Ashington258/Boost_Control/image/MCU.png

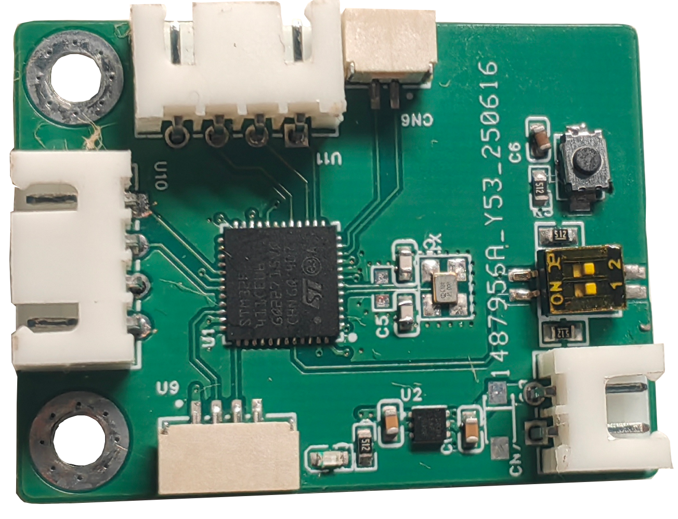
image/MCU.png
