Ashington258/Boost_Control/test/占空比裕度测试.md

# 占空比裕度测试
额定负载 100Omega情况下测试

| 输入电压 | 输出电压 | 占空比 | ADC电压 |
| --- | --- | --- | --- |
| 18V | 61.94V | 25% | 5.437V  |
| 18V | 53.436V  | 30% | 4.741V  |
| 18V | 40.108V  | 40% | 3.677V  |
| 18V | 32.822V  | 50% | 2.991V  |
| 18V | 27.720V  | 60% | 2.524V  |
| 18V | 23.959V  | 70% | 2.175V  |
