Ashington258/Boost_Control/image/Figure_1.png

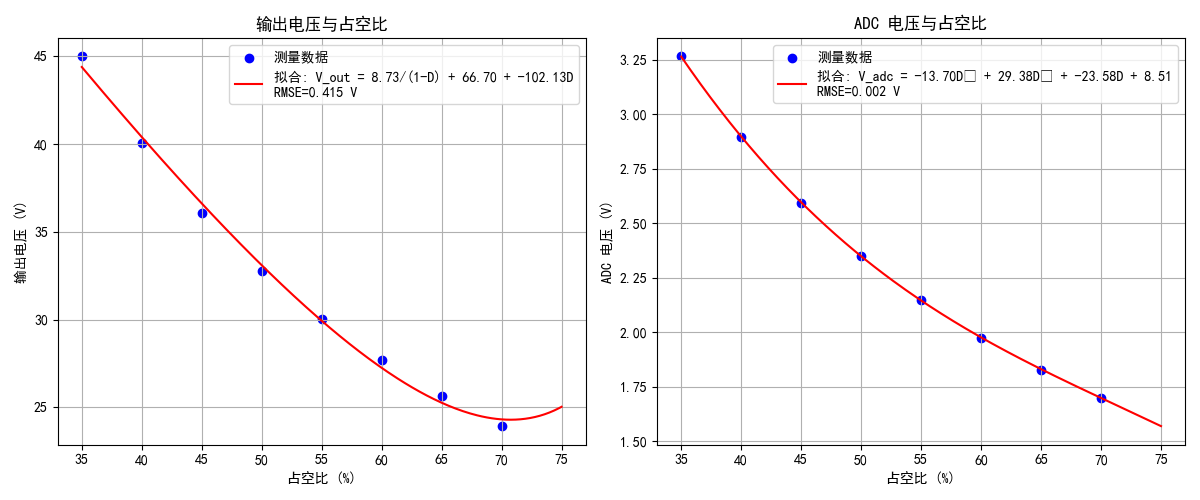
image/Figure_1.png
