Ashington258/Boost_Control/image/Figure_2.png

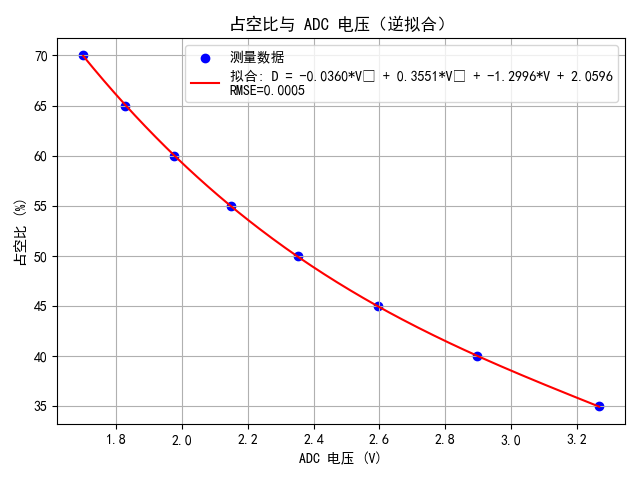
image/Figure_2.png
