Ashington258/Boost_Control/image/PWM_VADC.png

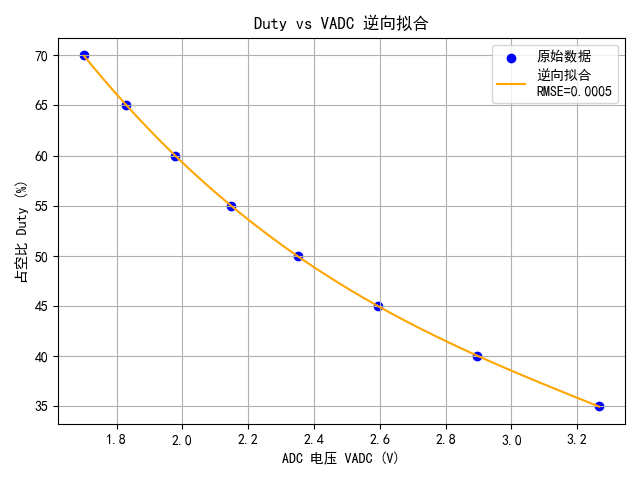
image/PWM_VADC.png
