Ashington258/Boost_Control/image/U0_VADC.png

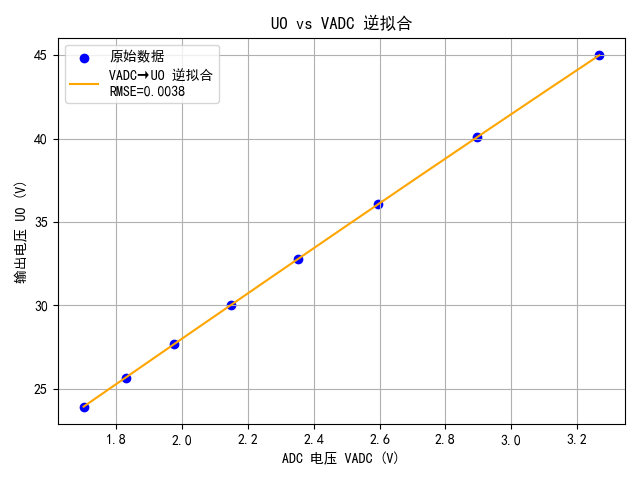
image/U0_VADC.png
