Ashington258/Boost_Control/image/vadc_PWM.png

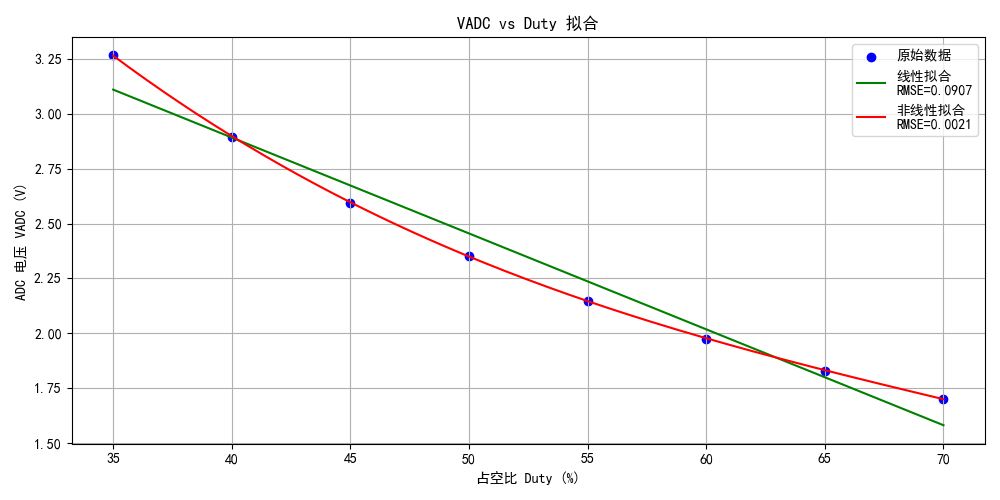
image/vadc_PWM.png
