Ashington258/Boost_Control/image/vadc_U0.png

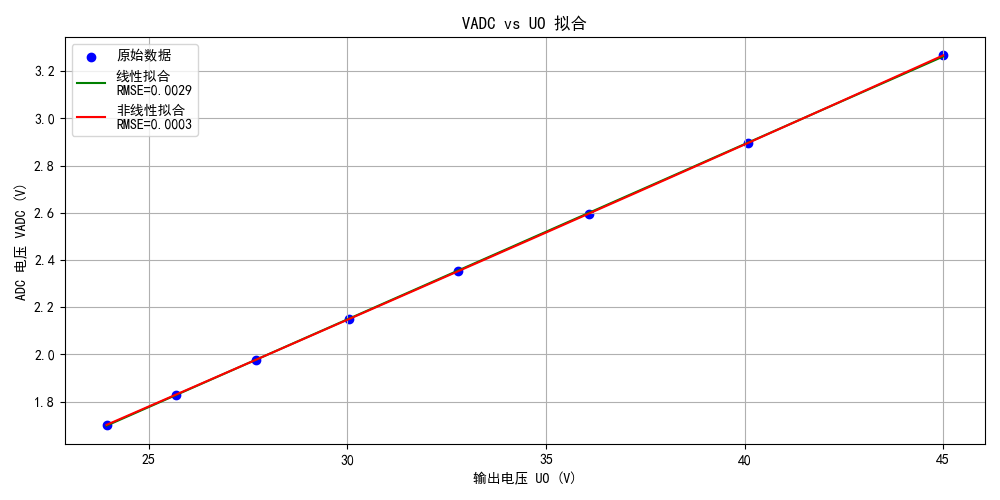
image/vadc_U0.png
