Ashington258/Boost_Control/电力电子综合设计资料2025/5 电气22级电力电子综合设计材料清单-学生.xlsx

电气22级电力电子综合设计器件清单
序号 | 数量 | 器件类型 | 编号 | 封装 | 封装 | 数值 | Manufacturer Part | 制造商 | 供应商编号 | 供应商
1 | 4 | 电解电容 | C1,C2,C4,C5 | CAP-TH_BD16.0-P7.50-D1.2-FD | 插件,D16x25mmm | 470uF | KM477M100K25RR0VH2FP0 | CX(承兴) | C72551 | LCSC
2 | 2 | 薄膜电容 | C3,C6 | CAP-TH_L7.2-W6.0-P5.00-D0.6 | 插件,P=5mm | 1uF | PE105J2A0501 | KYET(科雅) | C390180 | LCSC
3 | 2 | 直插独石电容 | C7,C8 | CAP-TH_L4.8-W3.2-P5.08-D1.2 | 插件,P=2.54mm | 100nF | CT4G-0805-2X1-50V-0.1μF-K | TORCH(火炬) | C141981 | LCSC
4 | 3 | 电解电容 | C9,C10,C11 | CAP-TH_BD5.0-P2.00-D0.8-FD | 插件,D5xL11mm | 10uF | KF100M035C110A | CapXon(台湾丰宾) | C62621 | LCSC
5 | 2 | 可拆式螺钉式PCB接线端子 | CN1,CN2 | CONN-TH_WJ2EDGV-5.08-2P | 插件,P=5.08mm，配套WJ2EDGK-5.08-2P |  | WJ2EDGV-5.08-2P | KANGNEX(康奈克斯电气) | C8461 | LCSC
6 | 1 | 肖特基二极管 | D1 | SMB_L4.6-W3.6-LS5.3-R-RD | SMA(DO-214AC) |  | SS310B | MDD | C14281 | LCSC
7 | 1 | 圆形整流桥 | D2 | DIO-BG-TH_2W10 | DIP-4 |  | 2W10 | MDD | C3064 | LCSC
8 | 3 | 开关二极管 | D3,D4,D5 | DO-35_BD2.0-L4.0-P8.00-D0.5-FD | DO-35 |  | 1N4148 | ST(先科) | C14516 | LCSC
9 | 1 | 自恢复保险丝 | F1 | FUSE-TH_L20.0-W4.5-P5.10-D0.8-S3.00 | 插件,P=5.1mm |  | JK250-1000U | JK(金科) | C369137 | LCSC
10 | 1 | 直插方针（1脚） | H1 | HDR-TH_4P-P2.54-V-M | 插件,P=2.54mm |  | B-2100S04P-A110（接至单片机） | Ckmtw(灿科盟) | C124378 | LCSC
11 | 1 | 直插方针（1脚） | H2 | HDR-TH_4P-P2.54-V-M | 插件,P=2.54mm |  | B-2100S04P-A110 | Ckmtw(灿科盟) | C124378 | LCSC
12 | 4 | 直插方针（1脚） | H3测试点（IDEC检测）,H4测试点(UO检测),H5测试点 |  | 插件,P=2.54mm
13 | 1 | 功率电感 | L1 | IND-SMD_L10.6-W10.2 | 贴片,11x10mm | 100uH | PSPMAC1045H-101M-ANP | PROD(谱罗德) | C436577 | LCSC
14 | 2 | 直插发光二极管 翠绿 | LED1,LED2 | LED-TH_BD3.0-P2.54-FD-GREEN | 插件，D=3mm |  | 204-10SUGD/S400-A5 | EVERLIGHT(亿光) | C99761 | LCSC
15 | 1 | 功率开关管MOSFET | Q1 | TO-220-3_L10.0-W4.5-P2.54-L | TO-220 |  | IRF540NPBF | Infineon(英飞凌) | C2566 | LCSC
16 | 1 | 金属膜电阻 | R1 | RES-TH_BD2.3-L6.5-P10.50-D0.5 | 插件 | 510Ω | MF1/4W-510Ω±1% T52 | CCO(千志电子) | C119318 | LCSC
17 | 1 | 金属膜电阻 | R2 | RES-TH_BD2.5-L6.5-P10.50-D0.6 | 插件 | 100kΩ | MFR0W4F1003A50 | UNI-ROYAL(厚声) | C58597 | LCSC
18 | 1 | 金属膜电阻 | R3 | RES-TH_BD2.4-L6.3-P10.30-D0.6 | 插件 | 10Ω | MFR-25JT-52-10R | YAGEO(国巨) | C176452 | LCSC
19 | 4 | 金属膜电阻 | R4,R6,R7,R8 | RES-TH_BD2.3-L6.5-P10.50-D0.5 | 插件 | 10kΩ | MF1/4W-10KΩ±1% T52 | CCO(千志电子) | C119347 | LCSC
20 | 2 | 金属膜电阻 | R9,R10 | RES-TH_BD2.5-L6.5-P10.50-D0.6 | 插件 | 0Ω | RN1/4W0RT/BA1 | Tyohm(幸亚电阻) | C410698 | LCSC
21 | 1 | 金属膜电阻 | R11 | RES-TH_BD2.2-L6.5-P10.50-D0.6 | 插件 | 6.2kΩ | MFR0W4F6201A50 | UNI-ROYAL(厚声) | C61652 | LCSC
22 | 1 | 金属膜电阻 | R12 | RES-TH_BD2.5-L6.5-P10.50-D0.6 | 插件 | 2.7kΩ | MFR0W4F2701A50 | UNI-ROYAL(厚声) | C58615 | LCSC
23 | 1 | 金属膜电阻 | R13 | RES-TH_BD5.0-L15.5-P19.50-D0.7 | 插件 | 100mΩ | MF3WS-0.1Ω±1%T | 华星机电 | C714162 | LCSC
24 | 4 | 螺钉式接线端子 | U1,U2,U6,U8 | CONN-TH_2P-P3.50_L7.4-W7.0 | 插件,P=3.5mm | 插件,P=3.5mm | DB125-3.5-2P-GN-S | DIBO(地博电气) | C466970 | LCSC
25 | 1 | AD模数转换器 | U3 | PDIP-8_L9.6-W6.4-P2.54-LS7.6-BL | PDIP-8 有配套8脚座子 |  | ADC0832CCN/NOPB（用于采样电压及电流） | TI(德州仪器) | C385862 | LCSC
26 | 1 | 稳压芯片7812 | U5 | TO-220-3_L10.0-W4.5-P2.54-L | TO-220 有配套3脚排母 |  | L7812CV | HGC(华冠) | C519078 | LCSC
27 | 1 | 稳压芯片7805 | U7 | TO-220-3_L10.0-W4.5-P2.54-L | TO-220 有配套3脚排母 |  | L7805CV | ST(意法半导体) | C111887 | LCSC
28 | 1 | 运算放大器 | U15 | DIP-8_L9.7-W6.4-P2.54-LS7.6-BL | PDIP-8有配套8脚座子 |  | LM358AP | TI(德州仪器) | C163528 | LCSC
29 | 1 | 驱动芯片 | U16 | DIP-8_L9.9-W6.6-P2.54-LS7.62-BL | PDIP-8 有配套8脚座子 |  | IR2104PBF | Infineon(英飞凌) | C2959 | LCSC
30 | 1 | 稳压二极管 | ZD1 | DO-41_BD2.8-L4.2-P8.00-D0.7-FD | DO-41 |  | 1N4746A | ST(先科) | C2549 | LCSC
