Ashington258/Boost_Control/(list of files, cad)

Other CAD files:
电力电子综合设计资料2025/PWMOpenLoop20250603/Objects/main.obj
电力电子综合设计资料2025/PWMOpenLoop20250603/Objects/STARTUP.obj
电力电子综合设计资料2025/PWMOpenLoop20250603/Objects/ADC0832.obj
