Ashington258/Boost_Control/test/data/UO_VADC_ID_PWM.csv

D | UO | VADC | ID
35%
40%
45%
50%
55%
60%
65%
70%
75%
80%
