Ashington258/Boost_Control/hardware/PCB_PCB1_2_2025-07-04.pdf

# 功率部分

18V | 短接跳线

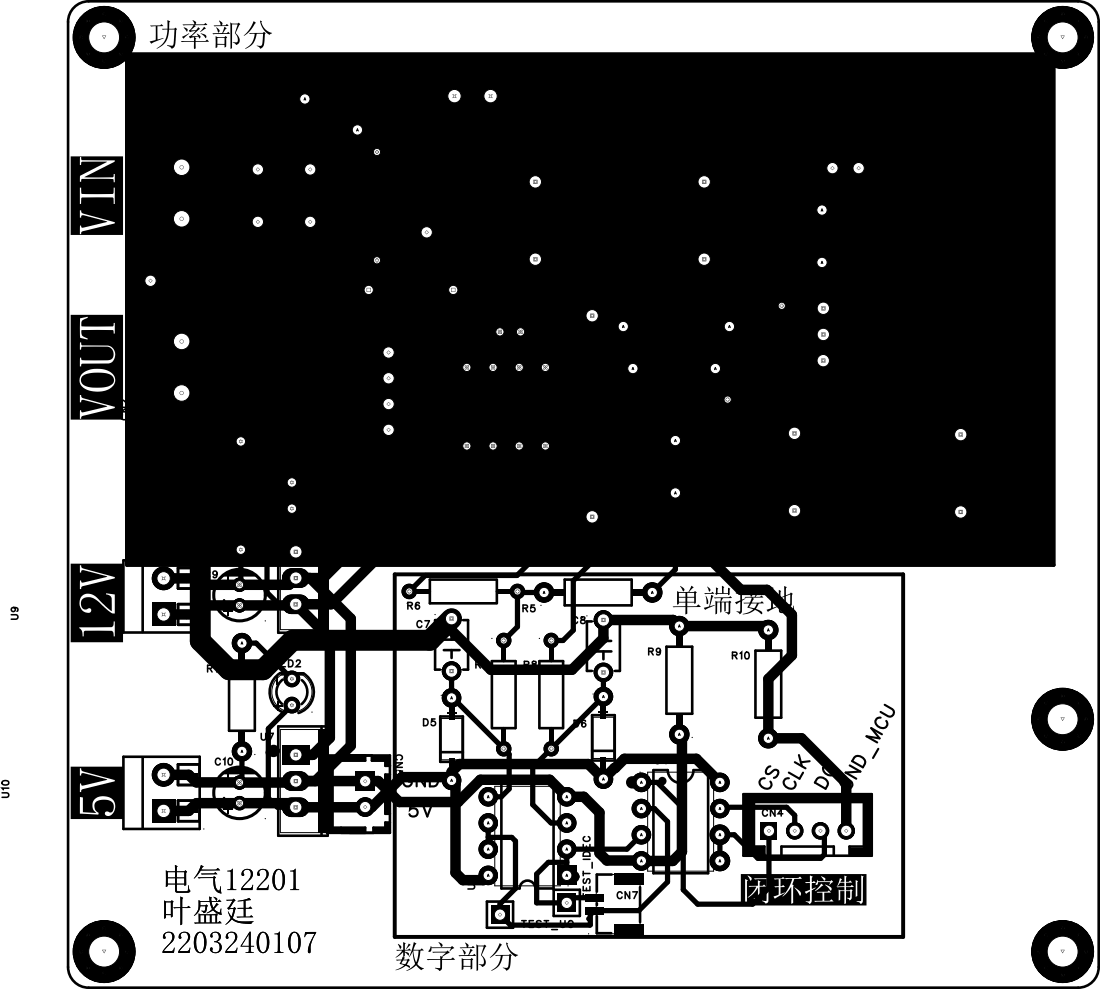
[picture p38: page 1]

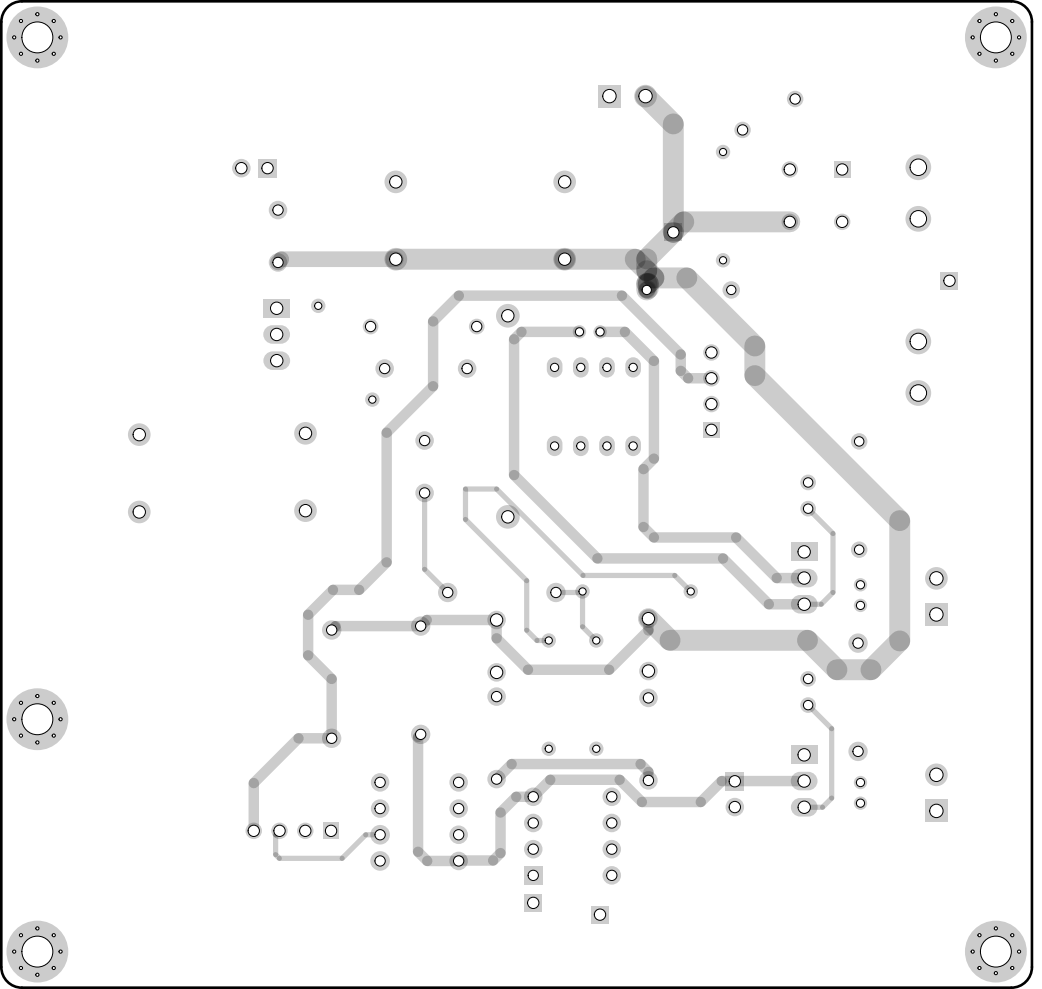
[picture p39: page 2]

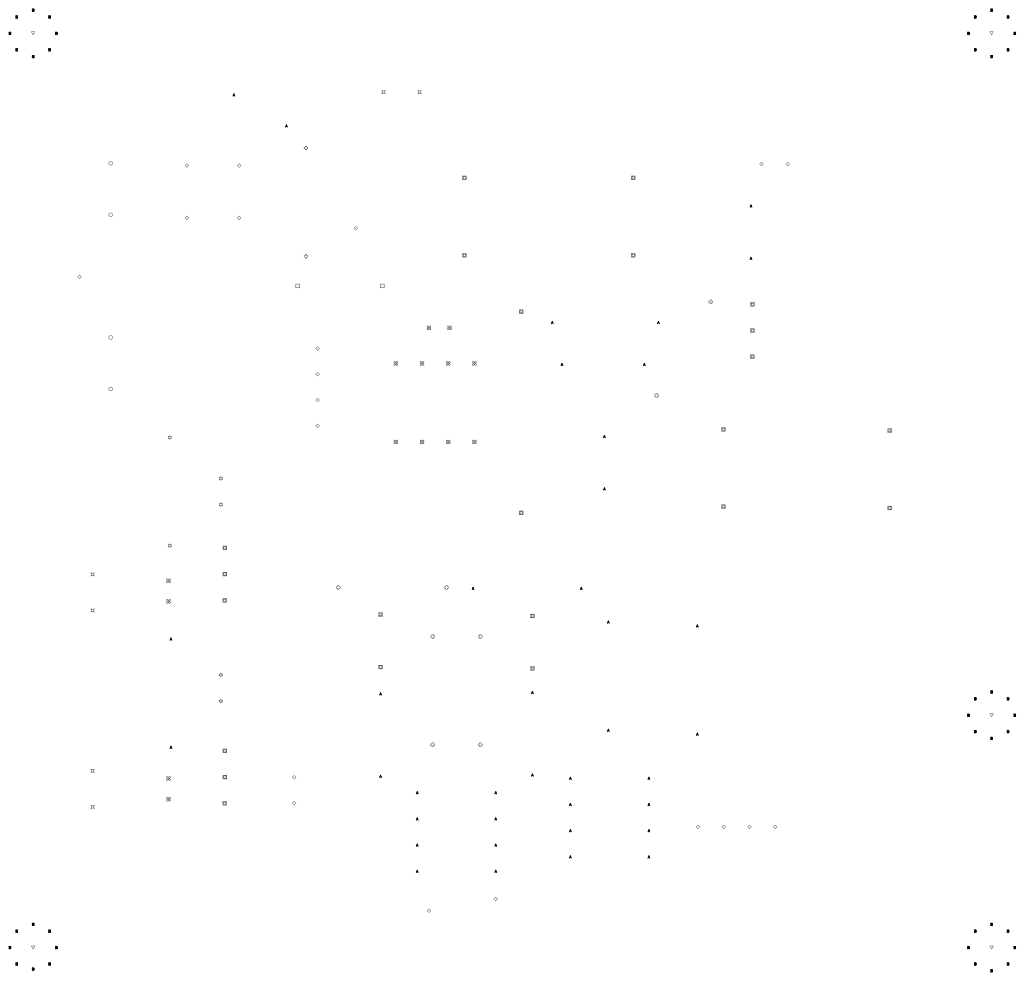
[picture p40: page 3]
