Ashington258/Boost_Control/hardware/SCH_Schematic1_2_2025-07-04.pdf

# 升压斩波电路

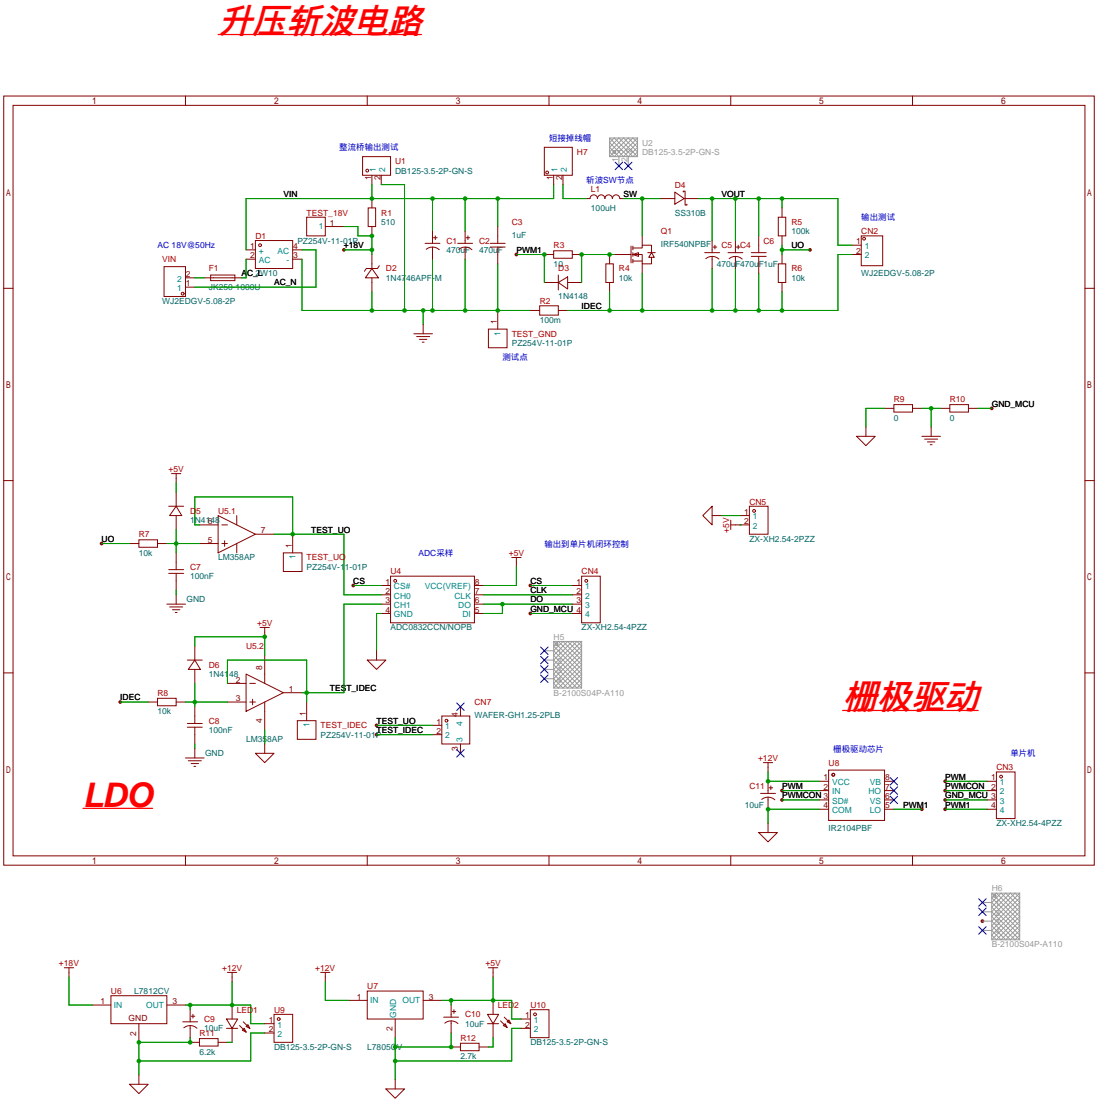
[picture p41: page 1]
