Ashington258/Boost_Control/电力电子综合设计资料2025/4 电气22级电力电子综合设计-基于单片机的开关电源原理图（参考).pdf

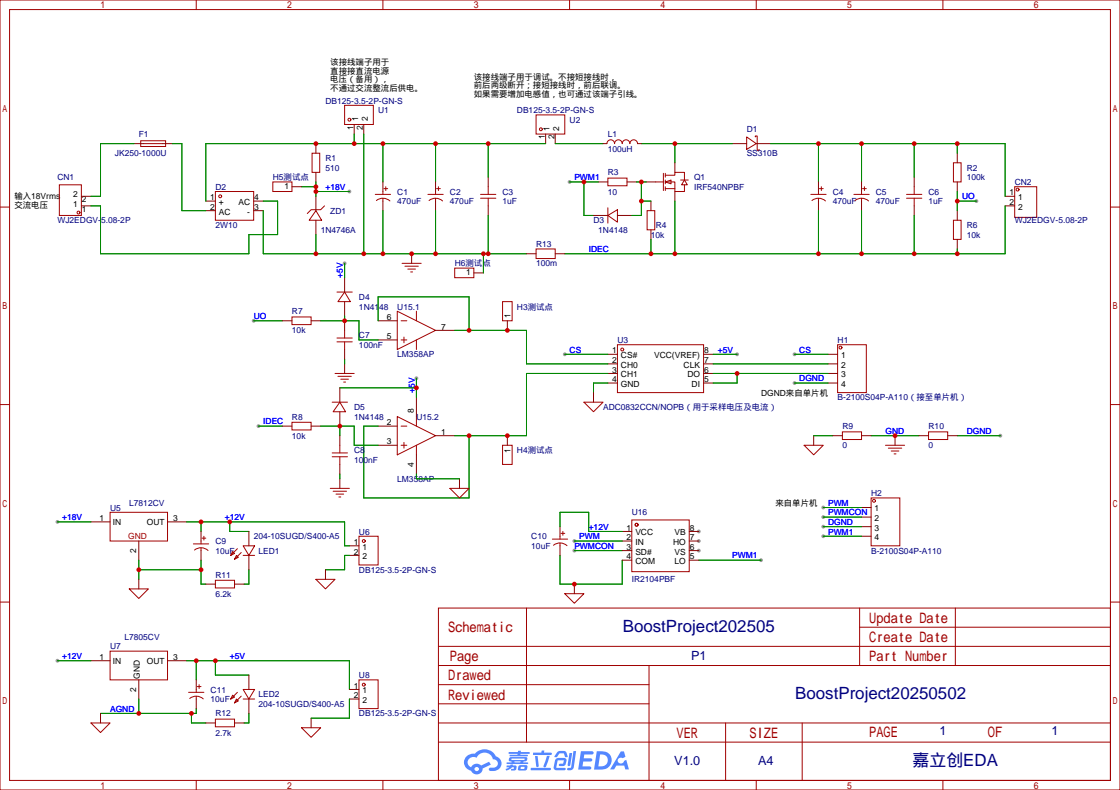
[picture p42: page 1]
