Ashington258/Boost_Control/(list of files, drawings)

Other design files:
hardware/ProPrj_电力电子综合设计_2025-07-04.epro
