Ashington258/Boost_Control/(commit log)

2025-06-24 构建工程
2025-06-24 refactor(main): 重构主控制逻辑并调整 PID 参数
    - 移除了 ADC 满值判断和 PWM 使能状态机
    - 简化了控制逻辑，直接使用 PID 控制器输出占空比
    - 调整了 PI 控制器参数，提高系统响应速度和稳定性
    - 优化了代码结构，提高了可读性和可维护性
2025-06-25 启用新的控制器
2025-06-25 perf(ADC): 调整 ADC 时钟预分频和触发方式
    - 将 ADC 时钟预分频从 ADC_CLOCK_SYNC_PCLK_DIV6 修改为 ADC_CLOCK_SYNC_PCLK_DIV4
    - 添加外部触发转换设置 ADC_SOFTWARE_START
    - 更新 ADC 初始化配置
    - 调整 IIR 滤波器初始化参数
2025-06-25 重构工程
    [U0_VADC.csv, UO_VADC_ID_PWM.csv, efficiency.csv]
2025-06-25 开发资料
    [5 电气22级电力电子综合设计材料清单-学生.xlsx, ADC0832.obj, STARTUP.obj, main.obj]
2025-06-25 开发文档
2025-07-04 增加硬件部分
    [ProPrj_电力电子综合设计_2025-07-04.epro]
